pavan-vl/CIMtegrity-Compute-in-memory-data-integrity-check/results/cim_col4cell_all.png

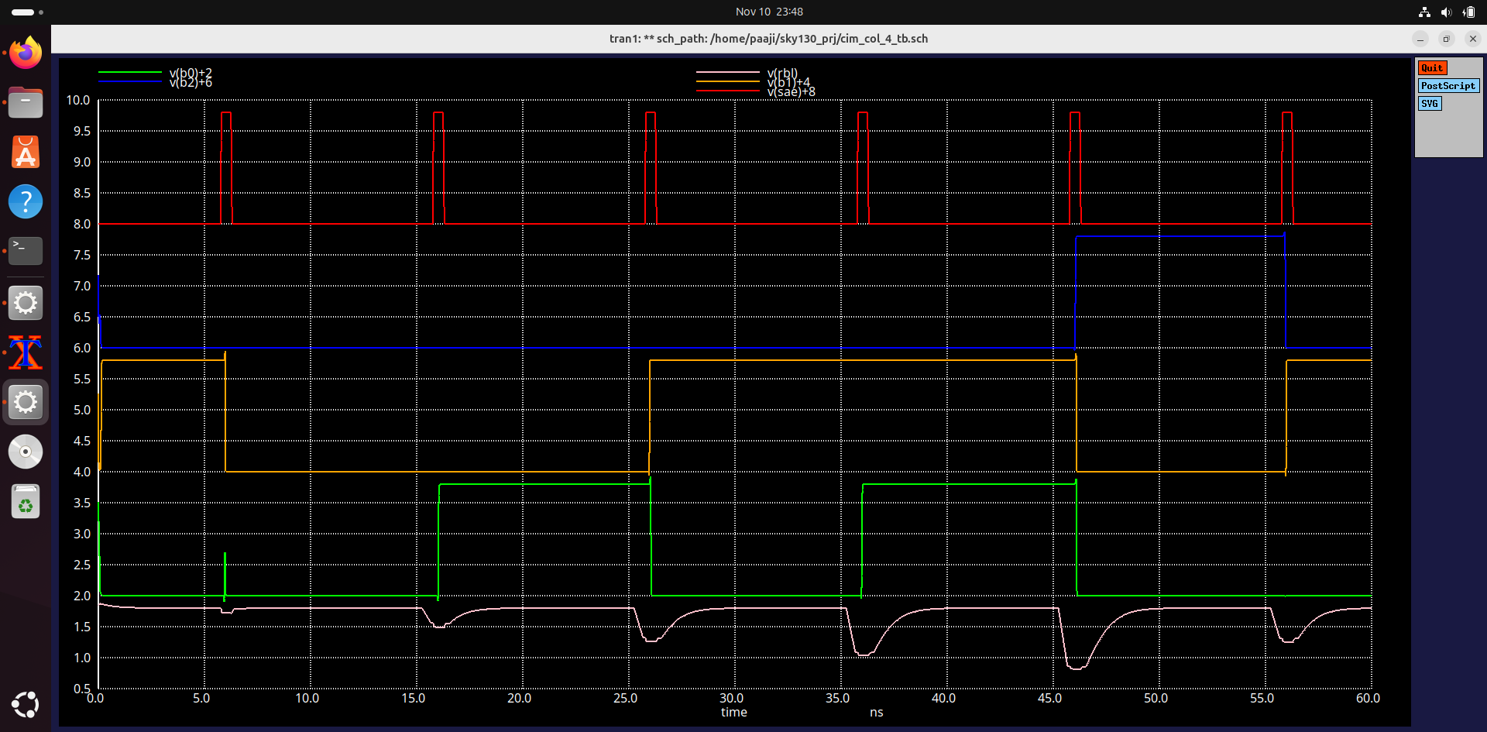
results/cim_col4cell_all.png
