pavan-vl/CIMtegrity-Compute-in-memory-data-integrity-check/results/cim_loigc_ff.png

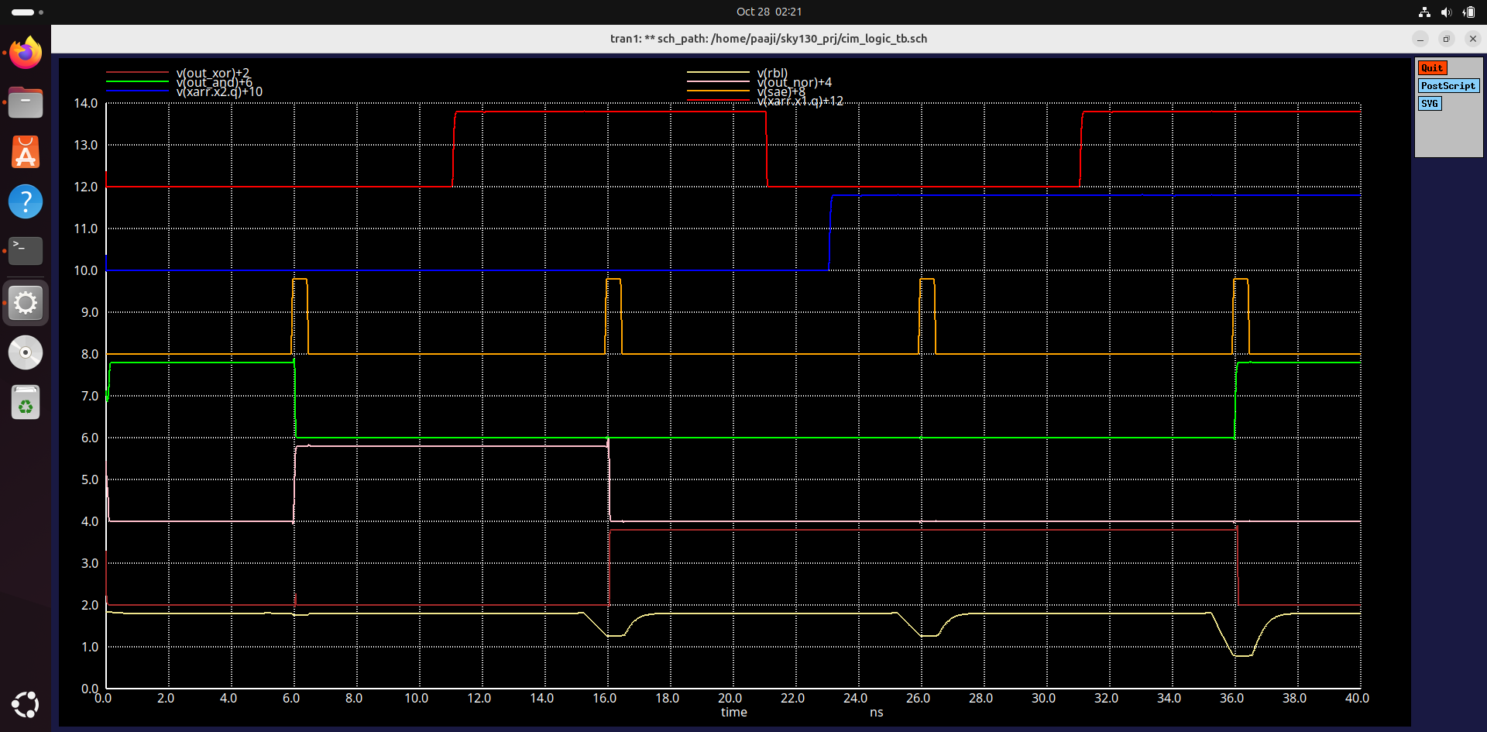
results/cim_loigc_ff.png
