pavan-vl/CIMtegrity-Compute-in-memory-data-integrity-check/results/cim_loigc_ss.png

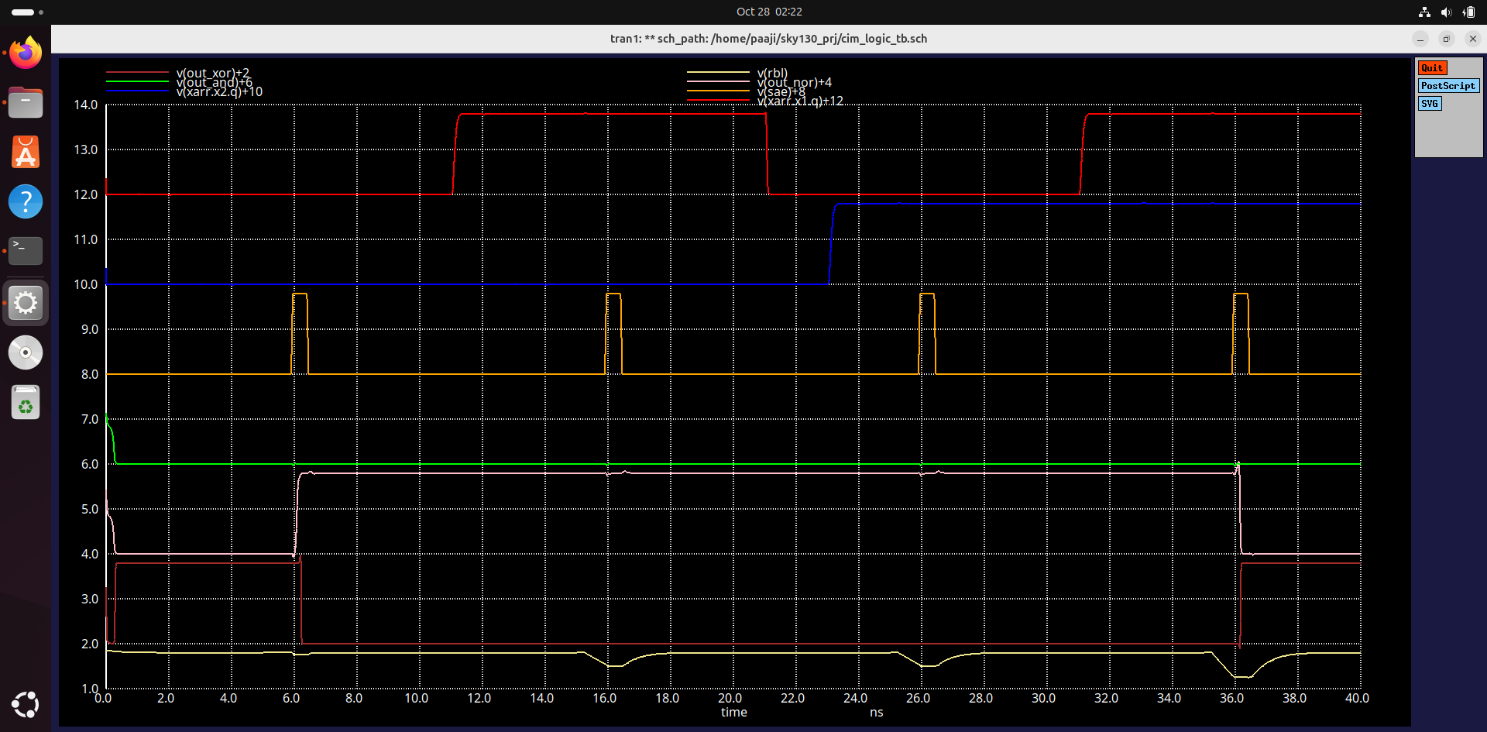
results/cim_loigc_ss.png
