pavan-vl/CIMtegrity-Compute-in-memory-data-integrity-check/results/single_col_4cell_all.png

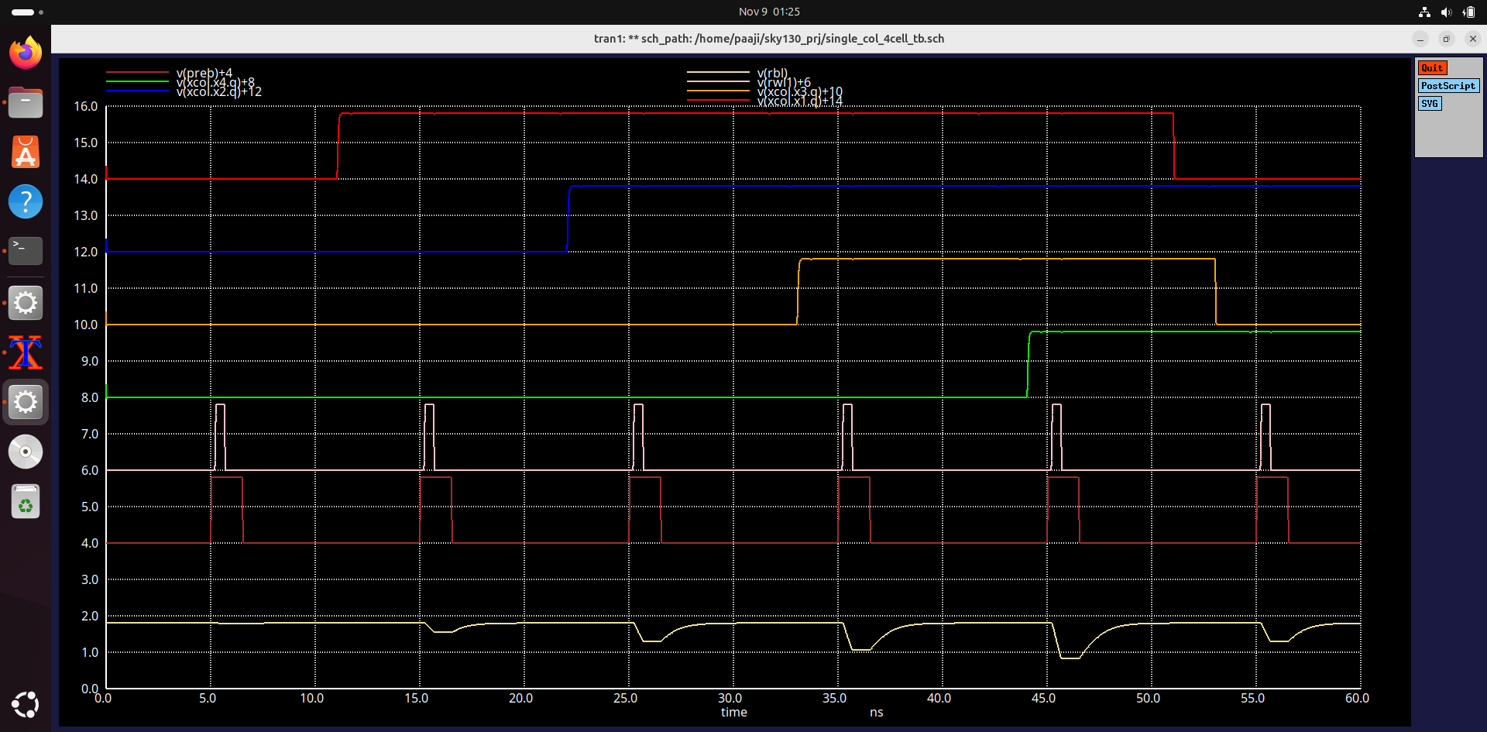
results/single_col_4cell_all.png
