pavan-vl/CIMtegrity-Compute-in-memory-data-integrity-check/results/sram_2cell_all.png

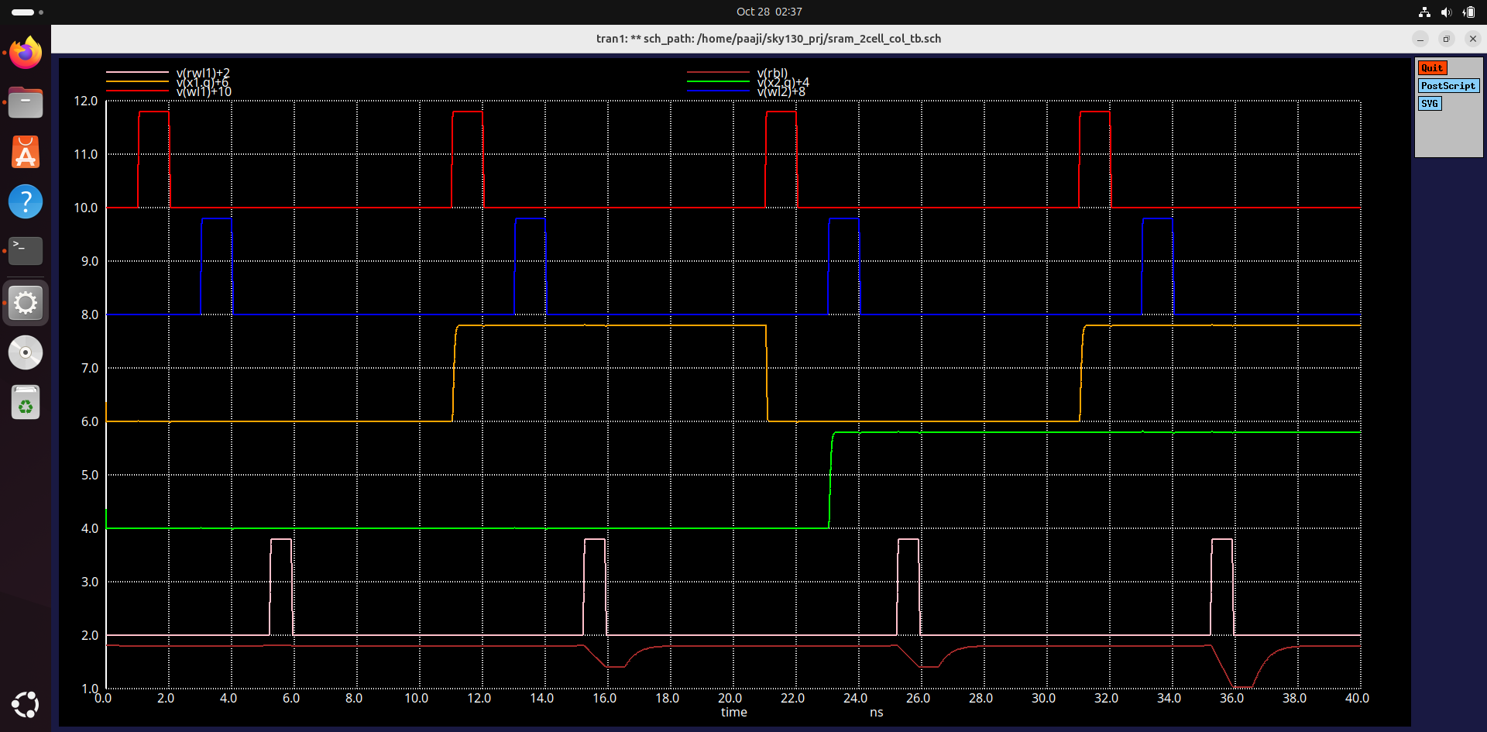
results/sram_2cell_all.png
