pavan-vl/CIMtegrity-Compute-in-memory-data-integrity-check/results/sram_cell_rbl.png

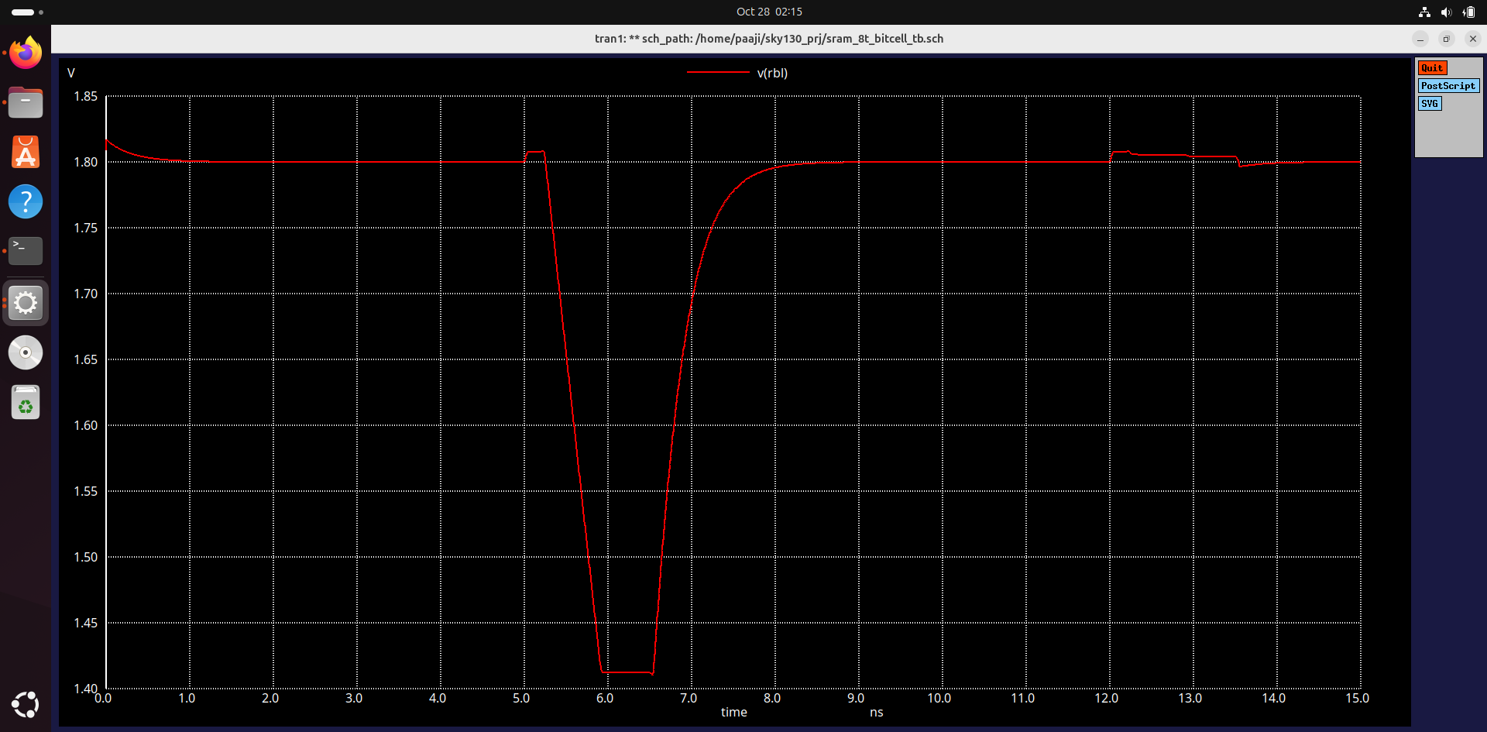
results/sram_cell_rbl.png
