pavan-vl/CIMtegrity-Compute-in-memory-data-integrity-check/results/strongarm_comparator_all.png

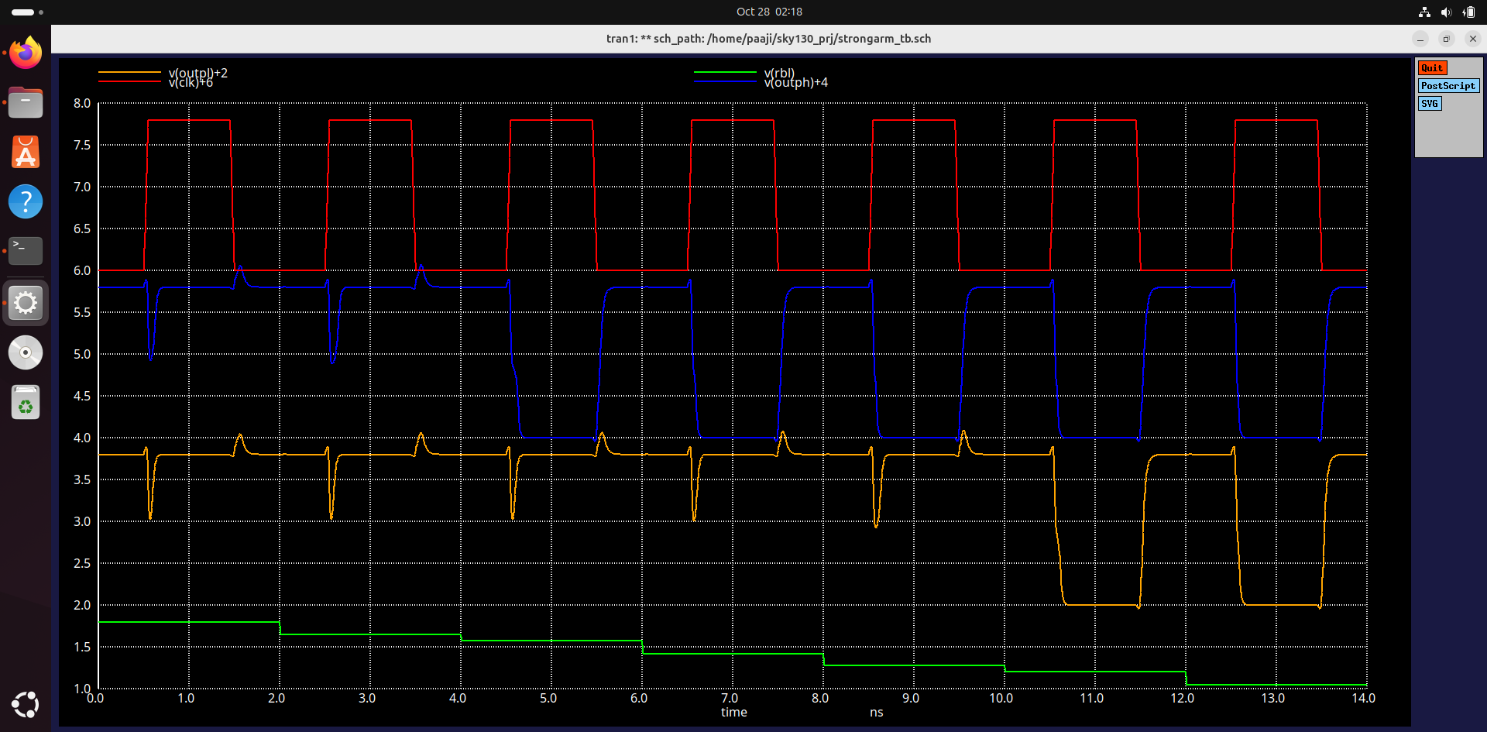
results/strongarm_comparator_all.png
